Marcozarg/mailbox_notifier/README.md

# Mailbox Notifier

LoRa-based mailbox sensor that pings Home Assistant (and your phone via Pushover) when
the postman opens your mailbox lid. Sender lives 50 m away in the mailbox, runs on a
2000 mAh LiPo for ~700 days. Receiver bridges LoRa packets to MQTT and Home Assistant.

Field-tested at **-70 to -84 dBm RSSI** through one large tree at 50 m.

```
┌────────────────────────┐                              ┌──────────────────────────┐
│  Mailbox sender        │                              │  House receiver          │
│  Adafruit Feather      │      LoRa @ 866 MHz, SF9     │  Heltec WiFi LoRa 32 V3  │
│   32u4 LoRa            │      ──────────────────►     │  (ESP32-S3 + SX1262)     │
│  + BME280              │      reed event +            │                          │
│  + reed switch         │      heartbeat packets       │  WiFi → MQTT → HA        │
│  + 2000 mAh LiPo       │                              │  → Node-RED → Pushover   │
└────────────────────────┘                              └──────────────────────────┘
```

---

## What it does

- **Mail-arrival notification** — lid opens → reed switch closes → LoRa packet → MQTT →
  iPhone Pushover within ~2 seconds.
- **Sticky state** in Home Assistant. Cleared by tapping a dashboard button or
  long-pressing the receiver's PRG button after you've checked the mailbox.
- **Environmental sensors** — temperature, humidity, pressure inside the mailbox (BME280).
- **Battery monitoring** — voltage + percentage, with a 6 h "low battery" heartbeat boost
  (vs the normal 48 h cadence) when it dips below 3.6 V.
- **Three-layer dedup** — sender 60 s lockout + receiver guard + Node-RED Trigger node —
  prevents bouncy lid double-notifications.
- **21 HA entities** auto-discovered under one "Mailbox" device card — no manual
  `configuration.yaml` editing.
- **Remote receiver reboot** — one-tap button in the HA device card.
- **Packet loss counter + frequency error sensor** — LoRa link health diagnostics.

---

## Hardware

### Sender (in the mailbox)

- Adafruit Feather 32u4 LoRa (RFM95 SX1276, 868 MHz)
- BME280 6-pin module (GY-BME280, I2C 0x76)
- Normally Open reed switch + magnet
- 2000 mAh 3.7 V LiPo
- External 868 MHz stubby antenna (+2 dBi) on u.FL pigtail

Full pinout, power tree, and reed mounting diagrams: [`HARDWARE.md`](HARDWARE.md).

### Receiver (in the house)

- Heltec WiFi LoRa 32 V3 (ESP32-S3 + SX1262 + OLED)
- USB-powered, mounted on a window

### Backend

- Home Assistant + Mosquitto MQTT add-on
- Node-RED add-on (Pushover bridge)
- Pushover account + iPhone

---

## LoRa link parameters

Both ends must match exactly.

| Parameter | Value |
|---|---|
| Frequency | 866.0 MHz |
| Bandwidth | 250 kHz |
| Spreading factor | 9 |
| TX power (sender) | +20 dBm PA_BOOST (reed/boot) · +14 dBm RFO (heartbeats) |
| Hardware CRC | enabled |
| Coding rate | 4/5 (library default) |

---

## Packet format

Key=value ASCII, ~60–70 bytes, ~190 ms airtime at SF9/250 kHz.

```
id=AA&type=1&seq=42&t=21.43&h=67&p=1013.2&v=3920&r=1&sok=1&boot=12&up=1234&br=normal&fw=V1.1.0
```

| Key | Meaning |
|---|---|
| `id` | Device ID — always `AA` |
| `type` | `1` reed/mail · `2` heartbeat · `3` low-batt heartbeat · `4` boot |
| `seq` | Sequence counter (uint8, wraps 0–255, resets on boot) |
| `t` | Temperature °C (BME280) |
| `h` | Humidity % (BME280) |
| `p` | Pressure hPa (BME280) |
| `v` | Battery voltage mV |
| `r` | Reed state at TX time (0 = lid closed, 1 = lid open). Diagnostic only — does **not** gate the mail-arrived state publish (see V1.2.6 bug fix) |
| `sok` | BME280 read OK (1 = fresh, 0 = sensor failed, values are last-known cache) |
| `boot` | EEPROM-backed boot count |
| `up` | Uptime in minutes since this boot |
| `br` | Boot reason: `power-on` / `external reset` / `watchdog` / `brown-out` / `normal`. Present in every packet (V1.1.0+) so HA always has a value |
| `fw` | Sender firmware version string (V1.0.9+) |

Forward-compatible by design — receiver ignores unknown keys.

---

## MQTT topic tree

| Topic | Direction | Retained | Notes |
|---|---|---|---|
| `mailbox/state` | RX ↔ HA | yes | `MAIL` / `EMPTY` — sticky, bidirectional |
| `mailbox/sender/temperature` | RX → HA | yes | °C |
| `mailbox/sender/humidity` | RX → HA | yes | % |
| `mailbox/sender/pressure` | RX → HA | yes | hPa |
| `mailbox/sender/battery_voltage` | RX → HA | yes | V |
| `mailbox/sender/battery_percent` | RX → HA | yes | %, computed from LiPo curve |
| `mailbox/sender/battery_days` | RX → HA | yes | estimated days remaining (V2.3.0+) |
| `mailbox/sender/packet_seq` | RX → HA | yes | sequence counter |
| `mailbox/sender/last_packet_type` | RX → HA | yes | human label: mail / heartbeat / heartbeat (low batt) / boot |
| `mailbox/sender/boot_count` | RX → HA | yes | EEPROM-backed |
| `mailbox/sender/boot_reason` | RX → HA | yes | power-on / external reset / watchdog / brown-out / normal |
| `mailbox/sender/sensor_ok` | RX → HA | yes | side channel, no HA entity |
| `mailbox/sender/alive` | RX → HA | yes | true/false, timeout-driven (98 h) |
| `mailbox/sender/version` | RX → HA | yes | sender FW string |
| `mailbox/sender/rssi` | RX → HA | yes | dBm of last RX packet (V2.1.0+) |
| `mailbox/sender/snr` | RX → HA | yes | dB of last RX packet (V2.1.0+) |
| `mailbox/sender/last_seen` | RX → HA | yes | ISO 8601 NTP timestamp (V2.1.0+) |
| `mailbox/sender/packet_loss` | RX → HA | yes | cumulative missed-seq count (V2.1.0+) |
| `mailbox/sender/freq_error` | RX → HA | yes | Hz, sender crystal drift (V2.1.0+) |
| `mailbox/receiver/online` | RX LWT | yes | true/false, LWT-managed |
| `mailbox/receiver/wifi_rssi` | RX → HA | yes | dBm |
| `mailbox/receiver/uptime` | RX → HA | yes | days, 2 decimals |
| `mailbox/receiver/crc_errors` | RX → HA | yes | cumulative CRC decode failures (V2.2.0+) |
| `mailbox/last_mail_at` | RX → HA | yes | ISO 8601 timestamp of last MAIL event (V2.2.0+) |
| `mailbox/cmd/reboot` | HA → RX | — | any payload → ESP.restart() (V1.3.0+) |

---

## Home Assistant integration

### MQTT discovery — 26 entities

Receiver publishes 25 retained `homeassistant/.../config` payloads at every boot. HA
auto-creates all entities under one **"Mailbox"** device card — no `configuration.yaml`
editing needed.

| Entity | Platform | Device class | Notes |
|---|---|---|---|
| `binary_sensor.mailbox_state` | binary | occupancy | `MAIL` / `EMPTY`, sticky |
| `sensor.mailbox_sender_temperature` | sensor | temperature | °C |
| `sensor.mailbox_sender_humidity` | sensor | humidity | % |
| `sensor.mailbox_sender_pressure` | sensor | pressure | hPa |
| `sensor.mailbox_sender_battery_voltage` | sensor | voltage | V, diagnostic |
| `sensor.mailbox_sender_battery` | sensor | battery | %, diagnostic |
| `sensor.mailbox_sender_battery_days` | sensor | — | estimated days remaining, diagnostic (V2.3.0+) |
| `sensor.mailbox_sender_packet_seq` | sensor | — | diagnostic |
| `sensor.mailbox_sender_last_packet_type` | sensor | — | diagnostic |
| `sensor.mailbox_sender_boot_count` | sensor | — | diagnostic |
| `sensor.mailbox_sender_boot_reason` | sensor | — | diagnostic |
| `binary_sensor.mailbox_sender_alive` | binary | connectivity | diagnostic |
| `sensor.mailbox_sender_version` | sensor | — | diagnostic |
| `sensor.mailbox_sender_rssi` | sensor | signal_strength | dBm, diagnostic |
| `sensor.mailbox_sender_snr` | sensor | — | dB, diagnostic |
| `sensor.mailbox_sender_last_seen` | sensor | timestamp | retained |
| `sensor.mailbox_sender_packet_loss` | sensor | — | total_increasing, diagnostic |
| `sensor.mailbox_sender_freq_error` | sensor | — | Hz, diagnostic |
| `binary_sensor.mailbox_receiver_online` | binary | connectivity | LWT, diagnostic |
| `sensor.mailbox_receiver_wifi_rssi` | sensor | signal_strength | dBm, diagnostic |
| `sensor.mailbox_receiver_uptime` | sensor | duration | days, diagnostic |
| `sensor.mailbox_receiver_free_heap` | sensor | data_size | bytes, diagnostic (V2.12.0+) |
| `sensor.mailbox_receiver_crc_errors` | sensor | — | total_increasing, diagnostic (V2.2.0+) |
| `sensor.mailbox_receiver_mail_source` | sensor | — | `reed_live`/`reed_deferred`/`boot_resync`/`broker_sync`, diagnostic (V2.13.0+) |
| `sensor.mailbox_last_mail_at` | sensor | timestamp | "X days ago", auto-rendered by HA (V2.2.0+) |
| `button.mailbox_receiver_reboot` | button | restart | triggers ESP.restart() |

### Entity naming rule (V1.2.0+) — important for firmware changes

HA auto-composes entity IDs as `<device_slug>_<object_id>`. The device slug is
`mailbox`. Therefore discovery payloads must **not** include `mailbox_` in `name`,
`unique_id`, or `object_id` — HA prepends it automatically.

| Discovery field | Correct | Wrong |
|---|---|---|
| `name` | `"Sender temperature"` | `"Mailbox sender temperature"` |
| `unique_id` | `"sender_temperature"` | `"mailbox_sender_temperature"` |
| `object_id` | `"sender_temperature"` | `"mailbox_sender_temperature"` |

Violating this rule produces doubled entity IDs like
`sensor.mailbox_mailbox_sender_temperature`. V1.1.0/V1.1.1 had this bug; V1.2.0 fixed it.

### Lovelace dashboard

The dashboard needs a button that publishes `EMPTY` (retained) directly to
`mailbox/state` to clear the sticky mail state. The receiver's `T_STATE` subscription
picks it up and syncs `mailState` locally.

---

## Node-RED flows

Four flow exports in `Node-RED/`. Import via HA Node-RED: **Menu → Import → paste
contents of each `.txt` file**.

Each file is versioned from V2.0.0. Version history is embedded as a comment node
inside each flow and visible in the Node-RED editor.

| File | Trigger | Message | Priority |
|---|---|---|---|
| `Node-RED_mail_arrived.txt` | `mailbox/state` → MAIL | "Postia laatikossa! (-95 dBm, 18°C)" — live RSSI from `mailbox/sender/rssi`, temperature from `mailbox/sender/temperature`; "Open mailbox" deep link opens HA app | 0, sound `siren` |
| `Node-RED_battery_low.txt` | `mailbox/sender/last_packet_type` = `"heartbeat (low batt)"` | "Mailbox battery low" — repeats every 7 days until normal heartbeat arrives (V2.2.0+) | 0, sound `siren` |
| `Node-RED_sender_boot.txt` | `mailbox/sender/boot_count` changes (rbe node blocks retained replay) | "Sender rebooted (reason: …, boot #N)" | 0, sound `siren` |
| `Node-RED_no_mail_alert.txt` | Daily 09:00 cron — if `mailbox/last_mail_at` > 7 days ago | "Ei postia N päivään" | 1, sound `falling` (V2.2.0+ receiver required) |

All flows use broker `HomeassistantMQTT` (localhost:1883), Pushover device `iphone`,
title `Mailbox`.

> **Note:** The battery low switch node must match the string `"heartbeat (low batt)"`
> — the human label published by the receiver — not the raw integer `"3"`.

---

## Building

### Prerequisites

**Tools:**
- Arduino IDE 2.x (tested on 2.3.9)
- Git

**Board packages** (Arduino IDE → Board Manager):
- `esp32` by Espressif Systems — for the Heltec V3 receiver
- `Adafruit AVR Boards` by Adafruit — for the Feather 32u4 sender

**Libraries** (Arduino IDE → Library Manager):

| Library | For | Install name |
|---|---|---|
| `heltec_esp32_lora_v3` by ropg | Receiver | `heltec_esp32_lora_v3` |
| `ArduinoMqttClient` by Arduino | Receiver | `ArduinoMqttClient` |
| `LoRa` by Sandeep Mistry | Sender | `LoRa` |
| `Adafruit BME280 Library` by Adafruit | Sender | `Adafruit BME280 Library` |
| `Low-Power` by Rocket Scream | Sender | `Low-Power` |

Board targets:
- Receiver: **Heltec WiFi LoRa 32(V3)**
- Sender: **Adafruit Feather 32u4**

---

### Sender wiring

Full wiring reference with diagrams: [`HARDWARE.md`](HARDWARE.md).

**Critical non-obvious points:**

> ⚠ **Reed switch mounting is INVERTED.** The reed is Normally Open (NO) type. Mount
> so the reed is **closed only when the lid is OPEN** (magnet near reed = lid open).
> The standard mounting (magnet on lid, reed on body, aligned when lid closed) is the
> **wrong polarity** — it would drain the battery and never trigger mail events.
> See `HARDWARE.md §1.5` for mounting diagrams.

| Connection | Feather silkscreen | Notes |
|---|---|---|
| BME280 VCC | **3V** | Use 3V3 only — not BAT/USB rails |
| BME280 GND | **GND** | |
| BME280 SDA | **SDA** | |
| BME280 SCL | **SCL** | |
| BME280 CSB | **3V** | Forces I2C mode (LOW = SPI → wrong) |
| BME280 SDO | **GND** | Sets I2C address to **0x76** |
| Reed terminal 1 | **RX** (= D0, INT2) | |
| Reed terminal 2 | **GND** | No external resistor — uses AVR internal pull-up |

Verify BME280 I2C address with a scanner sketch before continuing — should report `0x76`.
If you see `0x77`, SDO is not at GND.

---

### arduino_secrets.h

Both devices use a local `arduino_secrets.h` (gitignored) copied from the `.example` template in each firmware folder.

**Receiver** (`firmware/mailbox_receiver/`):

```bash
cd firmware/mailbox_receiver/
cp arduino_secrets.h.example arduino_secrets.h
# edit arduino_secrets.h
```

| Field | Value |
|---|---|
| `SECRET_SSID` | Your WiFi network name |
| `SECRET_PASS` | Your WiFi password |
| `SECRET_MQTT_BROKER` | MQTT broker IP (e.g. `192.168.1.x`) |
| `SECRET_MQTT_USER` | Mosquitto username |
| `SECRET_MQTT_PASS` | Mosquitto password |
| `SECRET_DOMAINNAME` | Your LAN domain (e.g. `homenet.io`) — used for DHCP hostname |
| `LORA_AES_KEY` | 16-byte AES-128 key — must match the sender (V2.4.0+) |

**Sender** (`firmware/mailbox_sender/`):

```bash
cd firmware/mailbox_sender/
cp arduino_secrets.h.example arduino_secrets.h
# edit arduino_secrets.h
```

| Field | Value |
|---|---|
| `LORA_AES_KEY` | 16-byte AES-128 key — must match the receiver (V2.3.0+) |

The sender has no WiFi or MQTT, so only the AES key is needed. Generate a key with:

```bash
python3 -c "import os; print(', '.join(f'0x{b:02X}' for b in os.urandom(16)))"
```

> **Note:** The receiver (V2.4.0+) accepts both encrypted and legacy plaintext packets. OTA-flash the receiver first, then flash the sender at any convenient time — no service gap during the transition.

---

### Build toggles — sender

Set these **before** compiling. All live at the top of `mailbox_sender.ino`.

| Macro | Production | Bench | Effect |
|---|---|---|---|
| `DEBUG_NOSLEEP` | `0` | `1` | Bench mode: chip stays awake, prints sensor values once/second in Serial Plotter format, 5 s reed lockout |
| `DEBUG_HEARTBEAT_30S` | `0` | optional | Sub-toggle inside `DEBUG_NOSLEEP`: also fire heartbeat every 30 s |
| `ENABLE_SERIAL` | `0` | `1` | Compile Serial debug in/out |
| `DEBUG_LED` | `0` | `1` | Blue LED on D5 blinks ~100 ms after every LoRa TX |
| `BOOT_UPLOAD_WINDOW_MS` | `20000` | n/a | Holds USB-CDC alive 20 s after boot for re-flash via auto-reset. USB is disabled after this window. |

**For field deployment:** all set to `0`.

### Build toggles — receiver

| Macro | Default | Effect |
|---|---|---|
| `ENABLE_SERIAL` | `1` | Receiver is USB-powered — Serial diagnostics always on |

---

### Flash sequence

> Flash **receiver first**. The sender can't do anything useful until the receiver is
> listening and publishing discovery to HA.

**1. Flash receiver**

- Open `firmware/mailbox_receiver/mailbox_receiver.ino` in Arduino IDE
- Board: **Heltec WiFi LoRa 32(V3)**, Port: USB COM port
- Upload → watch Serial Monitor (115200 baud)
- Wait for: `[disc] Publishing 26 entity configs`
- In HA → Settings → Devices & Services → MQTT: "Mailbox" device should appear with
  26 entities. If it doesn't appear within 30 s, check that `arduino_secrets.h` has
  the correct broker address.

**2. Verify HA entities**

- Mailbox device card should show all 26 entities grouped correctly
- `binary_sensor.mailbox_state` should be `EMPTY`
- `binary_sensor.mailbox_receiver_online` should be `true`

**3. Flash sender**

- Set `DEBUG_NOSLEEP 1`, `ENABLE_SERIAL 1` for bench test first
- Open `firmware/mailbox_sender/mailbox_sender.ino`
- Board: **Adafruit Feather 32u4**, Port: USB COM port
- **Unplug LiPo before plugging USB** (undefined behaviour during reset spike)
- Upload
- Watch Serial Monitor: should print temperature, humidity, pressure, battery voltage
- Move a magnet near the reed switch → one LoRa packet should fire within 8 s

**4. Verify end-to-end**

- Trigger reed → `mailbox/state` should flip to `MAIL` in MQTT Explorer and HA
- Pushover notification should arrive on iPhone within ~5 s
- HA dashboard button (publishes `EMPTY` retained to `mailbox/state`) should clear the state

**5. Set sender to production mode**

- Set `DEBUG_NOSLEEP 0`, `ENABLE_SERIAL 0`, `DEBUG_LED 0`
- Re-flash the sender
- After `setup()` there is a 20 s upload window (`BOOT_UPLOAD_WINDOW_MS`). If you need
  to re-flash without opening the mailbox: press Reset on the Feather, wait 3 s, click
  Upload in Arduino IDE. USB is permanently disabled after the window closes.

---

### Node-RED import

1. Open Node-RED in HA (HA → Add-ons → Node-RED → Open Web UI)
2. Menu (top right) → **Import**
3. Paste the contents of `Node-RED/Node-RED_mail_arrived.txt` → Import
4. Repeat for `Node-RED_battery_low.txt`, `Node-RED_sender_boot.txt`, and `Node-RED_no_mail_alert.txt`
5. Click **Deploy**
6. Trigger the sender → Pushover notification should arrive

---

### OTA updates (receiver only)

Once the receiver is running, Arduino IDE lists it as a network port:
`mailbox at <IP>` (mDNS: `mailbox.local`).

- Select the network port in Arduino IDE
- Click Upload
- When prompted for a password: **leave the field blank and press OK**
  (the receiver has no OTA password — trust the LAN)
- OLED shows live `OTA xx%` during upload

The sender has no OTA — flashing it requires USB cable and the 20 s upload window
(or a physical trip to the mailbox to press Reset).

---

### Pre-flash checklist

Before every flash — sender or receiver:

1. **Right board selected?** Heltec WiFi LoRa 32 V3 ≠ V2 ≠ ESP32 Dev Module.
   Adafruit Feather 32u4 ≠ Feather M0 ≠ generic Arduino.
2. **Right port?** USB hubs reorder COM numbers — verify it didn't change.
3. **Sender: LiPo unplugged before connecting USB.** Charging logic handles both, but
   uploading while on battery has bricked Feather sketches (undefined behaviour during
   reset spike).
4. **`arduino_secrets.h` not open in another editor** that might silently save
   placeholder values.
5. **Version header bumped** in the `.ino` file you edited (per project coding rules).

---

### Troubleshooting

| Symptom | Likely cause | Fix |
|---|---|---|
| "Mailbox" device never appears in HA | MQTT TX buffer overflow — discovery JSONs (~350 bytes each) silently dropped | Verify `mqttClient.setTxPayloadSize(1024)` is in receiver setup (V1.0.2+ fix) |
| State stays EMPTY after reed trigger, sensor data updates | `r=0` gate bug (pre-V1.2.6) or receiver lost `mailbox/state` subscription | Flash V1.2.6+; `connectMqtt()` must call `subscribe(T_STATE)` on every reconnect |
| Mail event missed after HA reboot | Reed packet arrived during MQTT backoff window | Flash V1.2.5+; `pendingMailState` flag defers the publish until reconnect |
| Receiver stuck offline after HA/Mosquitto reboot, needs manual power cycle | Wedged WiFi/socket state that backoff retry alone can't clear | Flash V2.11.0+; forces `ESP.restart()` after 20 min of continuous MQTT disconnection |
| Mail event lost after a stuck-restart | Reed packet queued in `pendingMailState` (RAM) when the V2.11.0 watchdog rebooted | Flash V2.12.0+; pending mail event is persisted to NVS before restart and restored in `setup()` |
| MAIL state appears with no matching sender packet | Unknown — under investigation | Flash V2.13.1+; check `sensor.mailbox_receiver_mail_source` next time it happens — `reed_live`/`reed_deferred` confirm a real LoRa packet, `boot_resync` means the receiver just rebooted and adopted a pre-existing retained value (not new), `broker_sync` means some other MQTT client published directly to `mailbox/state` while the receiver was already running |
| OTA upload dies at ~50% (WinError 10054) | 30 s watchdog trips during 4 KB flash erase | Flash V1.1.1+; OTA callbacks must kick `esp_task_wdt_reset()` |
| PRG short-press doesn't wake OLED | `heltec_display_power(false)` cuts Vext, needs full re-init | Flash V1.0.5+; use `display.displayOff()` / `displayOn()` instead |
| No packets received at all | LoRa parameter mismatch | Verify both ends: 866.0 MHz, SF9, BW 250 kHz. Even 866 vs 866.0 can cause issues in some libs |

---

## Operating the system

### Sticky mail state

- Receiver publishes `mailbox/state = MAIL` (retained) on EMPTY→MAIL transition only.
- Clear by: HA dashboard button (publishes `EMPTY` retained to `mailbox/state`) **or**
  Heltec PRG long-press (≥ 1500 ms).
- State survives receiver reboots — the retained value is replayed from Mosquitto on
  reconnect and the receiver's `mailState` flag syncs via the `onMqttMessage` callback.

### PRG button

| Press | Action |
|---|---|
| Short (50 ms – 1499 ms) | Wake OLED if it timed out |
| Long (≥ 1500 ms) | Manually clear `mailbox/state` to `EMPTY` |

### OLED layout

```
WiFi MQTT  10:42           V2.4.0   ← top row: connection status + clock + FW version
                                    
         M A I L !                  ← big state (or "—" when empty)
                                    
21.4°C  67%  1013 hPa               ← latest sender values
Bat: 3.92V (78%)                    
RSSI -84  SNR 9.5  #42              ← sender link quality + seq
```

Auto-off after 10 min idle. Woken by PRG short-press.

### Sender-alive watchdog

If no packet is received for **98 h** (48 h heartbeat × 2 + 2 h slack), the receiver
publishes retained `mailbox/sender/alive = false`. HA can trigger a "battery dead?"
alert. The 98 h window tolerates one missed heartbeat before flagging.

### Three-layer reed dedup

The mailbox lid can bounce or swing open multiple times per mail event. Three layers
prevent duplicate notifications:

1. **Sender lockout (60 s):** after every reed TX, the sender detaches the reed
   interrupt and sleeps for ~64 s before re-arming. Implemented as WDT-only sleep
   (not `delay()`) so battery cost is negligible (~30 mAs total vs ~300 mAs awake-poll).
2. **Receiver guard:** rejects same-seq duplicate packets; also rejects a new MAIL
   state if one was published within the last 60 s.
3. **Node-RED Trigger node (60 s block):** on the Pushover output. Adjustable from
   the Node-RED UI without reflashing anything.

---

## Design decisions

| # | Decision | Choice | Why |
|---|---|---|---|
| 1 | Packet format | Key=value ASCII | Human-readable, forward-compatible (receiver ignores unknown keys), easy to debug on OLED. Binary would save ~80 ms airtime — not worth it at 1–2 packets/day |
| 2 | MQTT discovery | Yes | HA auto-creates all 26 entities; no `configuration.yaml` to maintain |
| 3 | Heartbeat cadence | 48 h normal, 6 h when vbat < 3.6 V | 48 h halves TX count vs original 24 h; low-batt boost preserves dead-battery visibility without cost |
| 4 | Sender-alive timeout | 98 h (48 h × 2 + 2 h slack) | Tolerates one missed heartbeat before alerting |
| 5 | Sticky mail state | Manual clear only | Auto-clear on lid-close adds complexity with no benefit — user clears when they pick up the mail |
| 6 | Reed lockout | WDT-sleep 64 s | 10× less battery than staying awake for 60 s (`delay()`) |
| 7 | Reed dedup layers | 3 layers (sender + receiver + Node-RED) | Each layer protects against different failure modes; adjustable at Node-RED without reflashing |
| 8 | LoRa library (receiver) | RadioLib via `heltec_unofficial` | Multi-chip, well documented, SX1262 support |
| 9 | LoRa library (sender) | Sandeep Mistry `LoRa.h` | Already on board, works with SX1276, simple API |
| 10 | Sender MCU | Adafruit Feather 32u4 LoRa | Already wired, has LiPo charger, AVR PWR_DOWN sleep (~5 µA) |
| 11 | MQTT cleanSession | true | Receiver re-subscribes to `mailbox/state` and `mailbox/cmd/reboot` on every connect — no stale subscription state |
| 12 | OTA password | None | Trust the LAN — password adds friction to updates with no real security gain on a home network |
| 13 | Legacy topic compat | Removed in V1.1.0 | Clean break; old `mailboxstatus/*` topics were confusing and stale |
| 14 | BME280 I2C address | 0x76 (SDO→GND) | Frees 0x77 if a second sensor is ever added |
| 15 | Deferred features | buzzer, web page | Require sender reflash (physical trip) or significant complexity for marginal benefit. AES-128 fully implemented (sender V2.3.0 + receiver V2.4.0). |

---

## Build-time toggles

### Sender

| Macro | Production | Bench | Effect |
|---|---|---|---|
| `DEBUG_NOSLEEP` | `0` | `1` | Stays awake forever, Serial Plotter output, 5 s reed lockout |
| `DEBUG_HEARTBEAT_30S` | `0` | optional | Sub-toggle: fire heartbeat every 30 s while `DEBUG_NOSLEEP` is on |
| `ENABLE_SERIAL` | `0` | `1` | Compile Serial debug in/out |
| `DEBUG_LED` | `0` | `1` | Blue LED on D5 blinks ~100 ms per TX |
| `BOOT_UPLOAD_WINDOW_MS` | `20000` | n/a | USB-CDC stays alive 20 s after boot for re-flash via auto-reset. USB disabled after window. |

### Receiver

| Macro | Default | Effect |
|---|---|---|
| `ENABLE_SERIAL` | `1` | Serial diagnostics always on (USB-powered device) |

---

## Versioning

| Bump | Triggers |
|---|---|
| `Vx.y.z` patch | Bug fix, comment, typo, cosmetic only |
| `Vx.y` minor | Feature, behaviour tweak, UX change |
| `Vx` major | Hardware swap, MCU change, packet format break |

Every `.ino` has one `#define FW_VERSION "Vx.y.z"` near the top. The boot Serial log,
OLED display, and MQTT discovery `sw_version` all derive from it — the version string
can't drift between header and runtime.

---

## Deferred features

| Feature | Why deferred |
|---|---|
| Buzzer | Useful in-house alert, but requires GPIO wiring. Low priority when Pushover already works. |
| Web status page | Tiny HTTP server on the receiver. Convenient, but the OLED is right there. |

---

## Repo layout

```
.
├── firmware/
│   ├── mailbox_sender/             Sender firmware (Feather 32u4)
│   │   ├── mailbox_sender.ino
│   │   └── arduino_secrets.h.example   (copy → arduino_secrets.h, add LORA_AES_KEY)
│   └── mailbox_receiver/           Receiver firmware (Heltec V3)
│       ├── mailbox_receiver.ino
│       └── arduino_secrets.h.example   (copy → arduino_secrets.h, add WiFi/MQTT/LORA_AES_KEY)
├── Node-RED/                       Flow exports (import into HA Node-RED)
│   ├── Node-RED_mail_arrived.txt
│   ├── Node-RED_battery_low.txt
│   ├── Node-RED_sender_boot.txt
│   └── Node-RED_no_mail_alert.txt
├── HARDWARE.md                     Sender pinout, wiring, reed mounting diagrams
├── CHANGELOG.md                    Full version history
├── README.md                       This file
└── LICENSE                         MIT
```

---

## License

MIT — see [`LICENSE`](LICENSE).
