Marcozarg/mailbox_notifier/(commit log)

2026-05-25 V1.2.4 receiver — fix T_STATE re-subscribe on MQTT reconnect; add CLAUDE.md
2026-05-25 Add Node-RED flows: mail notification with RSSI, battery low alert
    - Node-RED_mail_arrived.txt: subscribes to mailbox/state and
    mailbox/receiver/rssi; appends live RSSI to mail notification
    ("Postia laatikossa! (-95 dBm)"); falls back gracefully if no
    RSSI seen yet
    - Node-RED_battery_low.txt: fix switch from raw type "4" to human
    label "heartbeat (low batt)" so the low-battery alert actually fires
2026-06-02 V1.2.5 receiver — fix silently lost reed event during MQTT backoff window
    When HA rebooted, the receiver entered exponential-backoff reconnect (up to
    5 min). A mail packet arriving after HA came back up but before the receiver
    reconnected was permanently lost: parseAndDispatch() skipped publishOnePacket()
    (MQTT down) and never set a retry flag, so nothing triggered the deferred
    publish on reconnect. Stale retained sensor values in Mosquitto made it appear
    the data "came through fine", masking the miss.
    Fix: add pendingMailState bool. Set it when a type=1 reed event is received
    while MQTT is disconnected. In connectMqtt(), publish MAIL *before* subscribing
    to T_STATE so the broker's retain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
2026-06-02 V1.2.6 receiver — fix state not publishing when r=0 in type=1 packet
    The receiver gated the mail-state publish on `lastPkt.reedOpen`, but the
    sender reads digitalRead(PIN_REED) at packet-build time — up to 8 s after
    the ISR fires plus ~10 ms for the BME280 read. If the lid closed in that
    window, the packet carries r=0 even though the reed event was real.
    Root cause: the r= field reflects reed state at build time, not at ISR time.
    For type=1 packets pktType==1 is already the authoritative mail-arrived
    signal from the sender's interrupt. Whether the reed is still open when the
    packet is assembled is irrelevant.
    Fix: remove `lastPkt.reedOpen` from the type=1 state-transition check.
    No sen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
2026-06-02 V1.3.0 receiver + Node-RED sender-boot notification
    Receiver firmware:
    - HA reboot command: subscribe mailbox/cmd/reboot, ESP.restart() on any message;
    button entity (device_class restart) published via MQTT discovery
    - Packet loss counter: gap detection in sender seq (uint8 wrapping arithmetic),
    cumulative count published to mailbox/receiver/packet_loss (retained)
    - Frequency error sensor: radio.getFrequencyError() published to
    mailbox/receiver/freq_error (Hz) on every RX
    - publishOneDiscovery() state_topic made optional (needed for button platform)
    - Entity count 18 → 21
    Node-RED:
    - New Node-RED_sender_boot.txt: mqtt-in mailbox/sender/boot_count → rbe
    (block unless changed, av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
2026-06-02 Fix filter node validation error: set topi to 'topic'
2026-06-02 Update docs: reflect V1.3.0, antenna upgrade, BME280, entity count
2026-06-02 Receiver V2.1.1: fix reboot button unique_id to match HA entity
2026-06-03 Node-RED flows V2.0.0: add version comment nodes, fix RSSI topic
2026-06-04 Receiver V2.2.0: last_mail_at sensor, CRC error counter; Node-RED no-mail alert
2026-06-05 Sender V2.1.0: lower heartbeat TX power; ADC cleanup
2026-06-05 Sender V2.1.1: eliminate double vbat ADC read per TX
2026-06-05 Receiver V2.3.0: battery days remaining sensor
2026-06-05 Docs: fix battery estimate, Node-RED import, OLED version in README
2026-06-06 Node-RED battery low: 7-day repeat reminder
2026-06-07 Docs: Node-RED battery low V2.2.0 — 7-day repeat reminder
2026-06-07 Docs: README — AES secrets section, file tree with example files
2026-06-07 Sender V2.3.1: inline AES-128-CTR; fix __vector_12 conflict with LowPower
    [mailbox_sender.ino]
2026-06-07 Receiver V2.5.0: OLED enc indicator, Bat:% replaces voltage
    [mailbox_receiver.ino]
2026-06-15 Receiver V2.5.1: retain all sensor and diagnostic values through HA boot
2026-06-15 Receiver V2.6.0: retain all sensor and diagnostic values through HA boot
2026-06-15 Receiver V2.7.0: sender_alive survives receiver reboot
    [mailbox_receiver.ino]
2026-06-15 Receiver V2.7.1: fix timegm — use portable civil-date formula
    [mailbox_receiver.ino]
2026-06-27 Receiver V2.9.0: OLED overhaul — live boot screen, IP row, combined bottom line
2026-06-27 Sender M0: use FALLING edge for reed interrupt (SAMD21 supports edge wakeup)
2026-06-27 Sender M0: detach USB after boot window to save LiPo current
2026-07-04 Node-RED mail arrived V2.4.0: add temperature to Pushover notification
2026-08-11 Receiver V2.11.0: force restart after 20 min of stuck MQTT disconnection
    [mailbox_receiver.ino]
2026-08-11 Receiver V2.12.0: persist pending mail event across stuck-restart, add free-heap diagnostic
    [mailbox_receiver.ino]
2026-08-16 Receiver V2.13.0: add mail_source diagnostic to trace MAIL state origin
2026-08-16 Receiver V2.13.1: fix mail_source false-positive on every reboot
    [mailbox_receiver.ino]
2026-10-09 Track CLAUDE.md, AGENTS.md and .gitignore; per-flow Node-RED releases; hook checks README topics
